cabal95/SolderDispenser/font2c/README.md

This utility is a modification from https://github.com/xenogenesi/font2c
