cabal95/SolderDispenser/atmega328.md

# ATmega328

## Pin Mapping

| HW Pin | Digital Pin | Other USe |
|---|---|---|
| 1 | n/a | Reset |
| 2 | Digital 0 | RX |
| 3 | Digital 1 | TX |
| 4 | Digital 2 | INT0 |
| 5 | Digital 3 | INT1, PWM |
| 6 | Digital 4 | |
| 7 | | VCC |
| 8 | | GND |
| 9 | | OSC1 |
| 10 | | OSC2 |
| 11 | Digital 5 | PWM |
| 12 | Digital 6 | PWM |
| 13 | Digital 7 | |
| 14 | Digital 8 | |
| 15 | Digital 9 | PWM |
| 16 | Digital 10 | SS, PWM |
| 17 | Digital 11 | MOSI, PWM |
| 18 | Digital 12 | MISO |
| 19 | Digital 13 | SCK |
| 20 | | AVCC |
| 21 | | AREF |
| 22 | | GND |
| 23 | Digital 14 | ADC0 |
| 24 | Digital 15 | ADC1 |
| 25 | Digital 16 | ADC2 |
| 26 | Digital 17 | ADC3 |
| 27 | Digital 18 | ADC4, SDA |
| 28 | Digital 19 | ADC5, SCL |
