cabal95/SolderDispenser/(commit log)

2021-02-11 - Implement motor controls.
2021-03-25 - Initial PCB designs.
    [board.kicad_pcb, board.kicad_sch, parts-bom.csv]
2021-03-25 Added support for the select button.
2021-03-27 Updted PCB for new SSD1306 display.
    [board.kicad_pcb, board.kicad_sch]
2021-03-27 Update parts, enable drill files.
    [board.kicad_pcb, parts-bom.csv]
2021-03-28 Fixed an overlapping trace that got missed in last DRC.
    [board.kicad_pcb]
2021-04-04 Fixed incorrect +5v to GND connection.
    [board.kicad_pcb, board.kicad_sch]
